MEDCVR/SuMI/cad/step/motor_holder.step

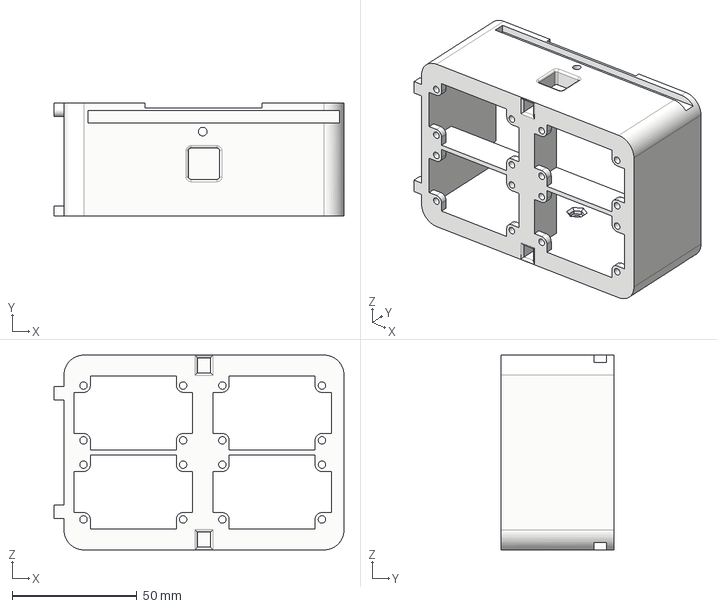
[picture p2: CAD file, 2026-10-09]
cad/step/motor_holder.step
116.4 x 45.5 x 78.2 mm
