MEDCVR/SuMI/cad/step/orthoplanar_spring.step

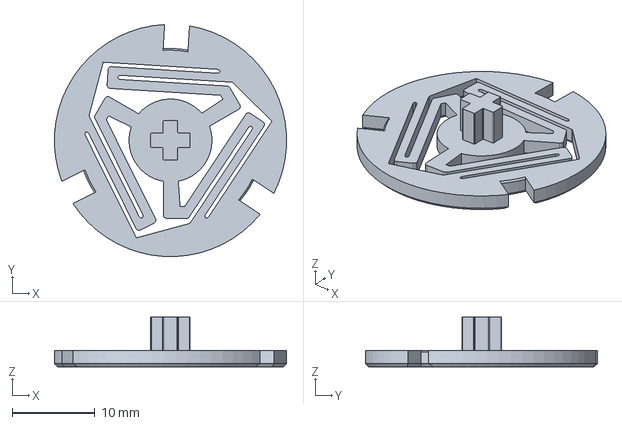
[picture p3: CAD file, 2026-10-09]
cad/step/orthoplanar_spring.step
28.0 x 28.0 x 6.00 mm
