MEDCVR/SuMI/cad/step/motor_cover.step

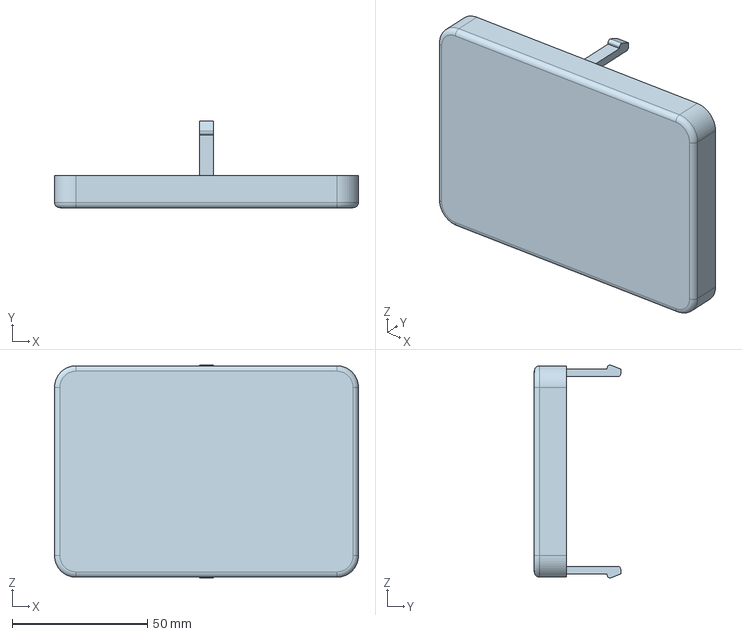
[picture p4: CAD file, 2026-10-09]
cad/step/motor_cover.step
112.4 x 32.0 x 78.8 mm
