MEDCVR/SuMI/cad/step/coupling_interface.step

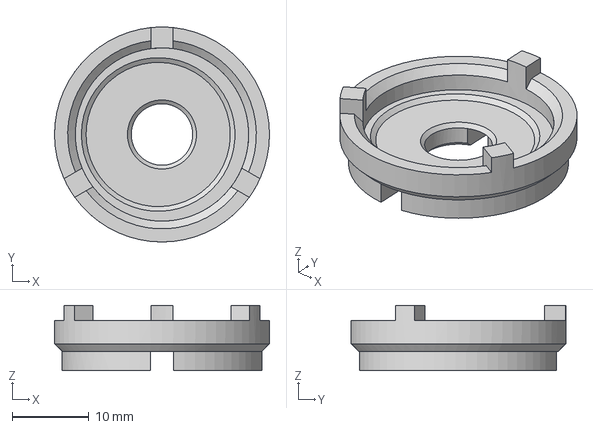
[picture p5: CAD file, 2026-10-09]
cad/step/coupling_interface.step
28.0 x 28.0 x 8.50 mm
