MEDCVR/SuMI/cad/step/mixel_shaft.step

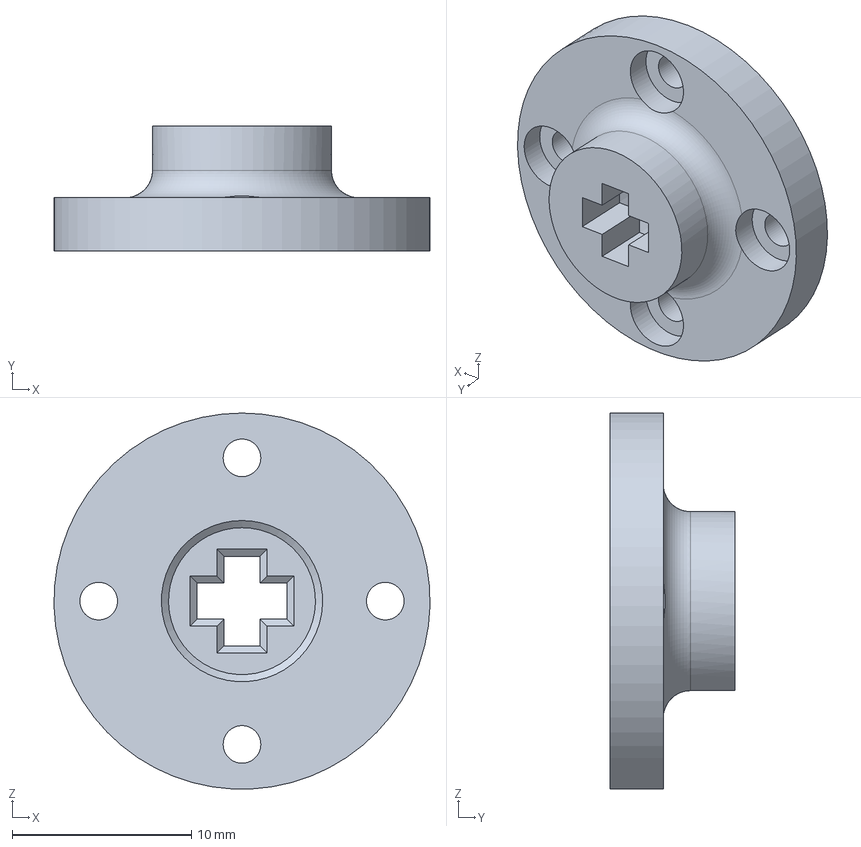
[picture p6: CAD file, 2026-10-09]
cad/step/mixel_shaft.step
21.0 x 7.00 x 21.0 mm
