MEDCVR/SuMI/cad/step/tool_holder_290mm+45deg+franka.step

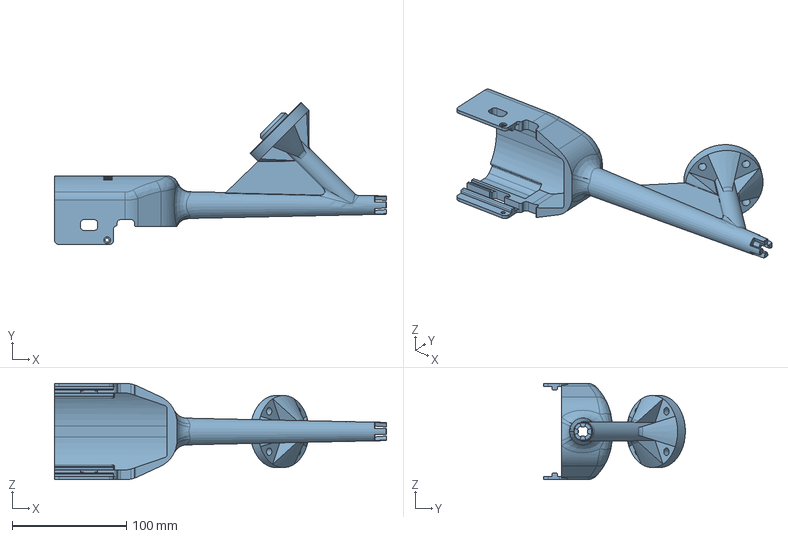
[picture p7: CAD file, 2026-10-09]
cad/step/tool_holder_290mm+45deg+franka.step
290.0 x 124.0 x 84.1 mm
