MEDCVR/SuMI/(list of files, cad)

Other CAD files:
cad/stl/coupling_interface.stl
cad/stl/mixel_shaft.stl
cad/stl/motor_cover.stl
cad/stl/motor_holder.stl
cad/stl/orthoplanar_spring.stl
cad/stl/tool_holder_290mm+45deg+franka.stl
